gfreundl/IR_Thermometer_LCD_Read/wiring on OEM board.jpg

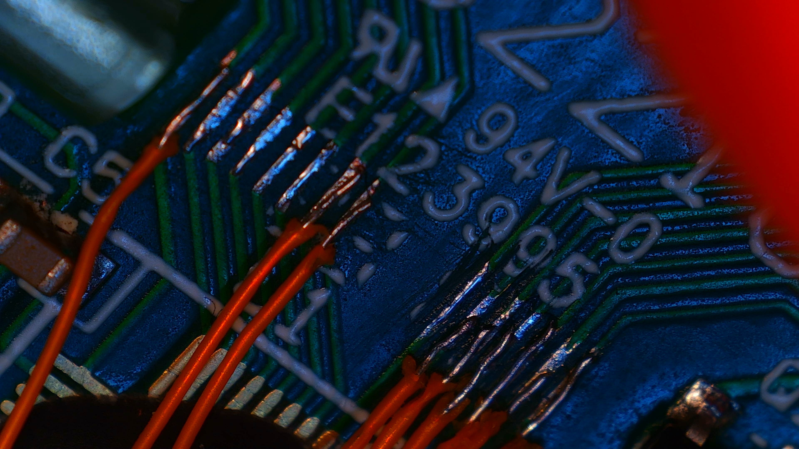
wiring on OEM board.jpg
