gfreundl/IR_Thermometer_LCD_Read/LCD matrix 4xCOM power up 200ms period.png

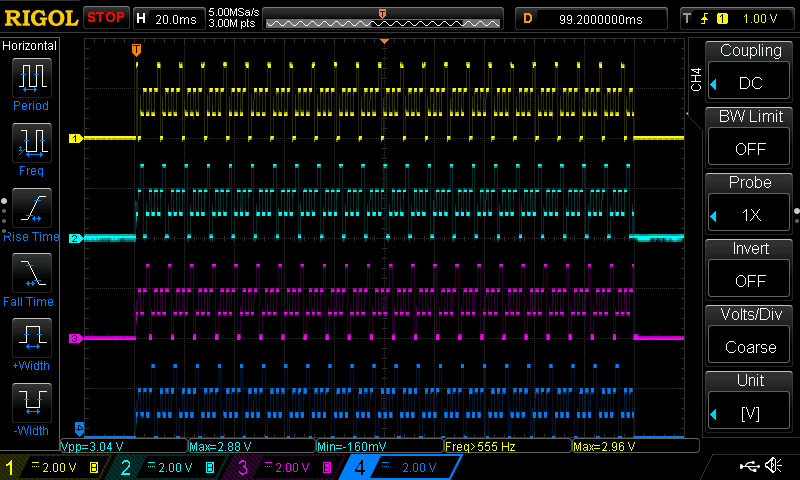
LCD matrix 4xCOM power up 200ms period.png
