gfreundl/IR_Thermometer_LCD_Read/LCD matrix 4xCOM power up initial phase.png

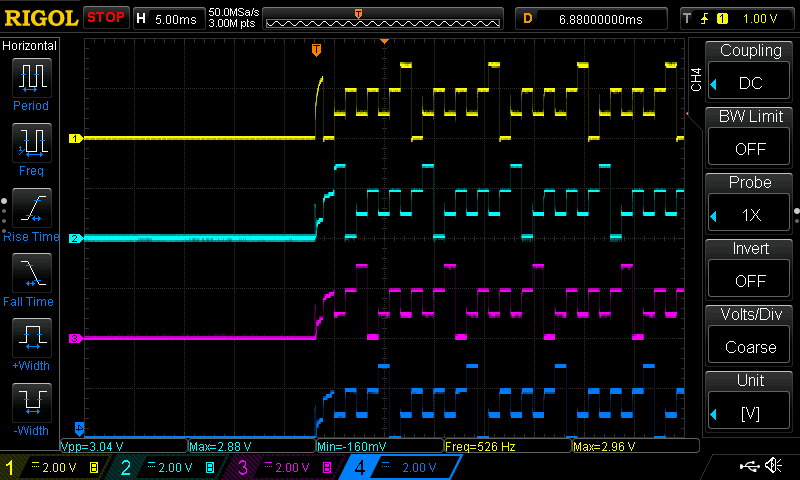
LCD matrix 4xCOM power up initial phase.png
