gfreundl/IR_Thermometer_LCD_Read/LCD matrix 4xCOM startup.png

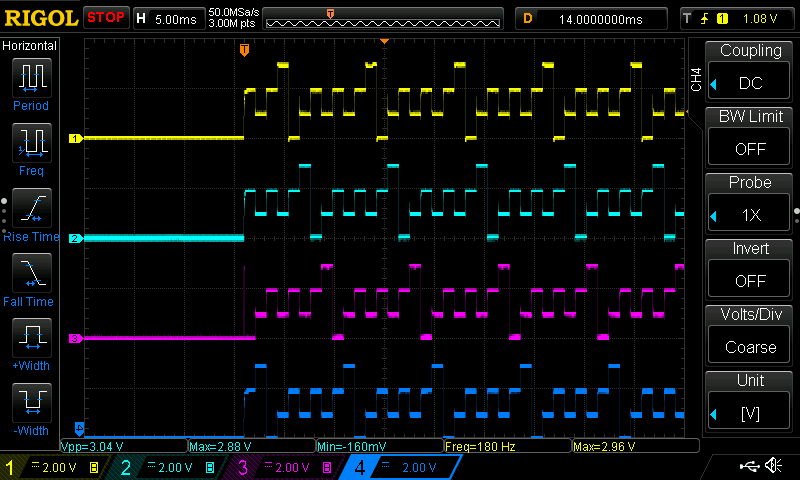
LCD matrix 4xCOM startup.png
