gfreundl/IR_Thermometer_LCD_Read/LCD matrix SEG startup  1960ms all digits.png

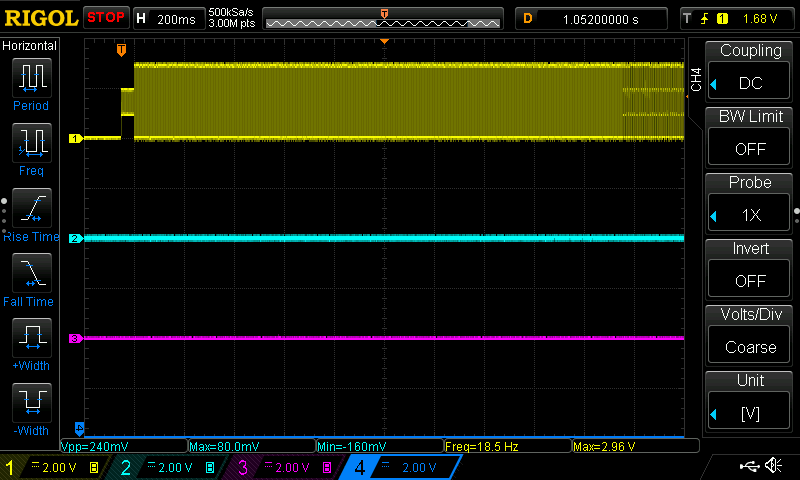
LCD matrix SEG startup 1960ms all digits.png
