gfreundl/IR_Thermometer_LCD_Read/LCD matrix SEG startup detail.png

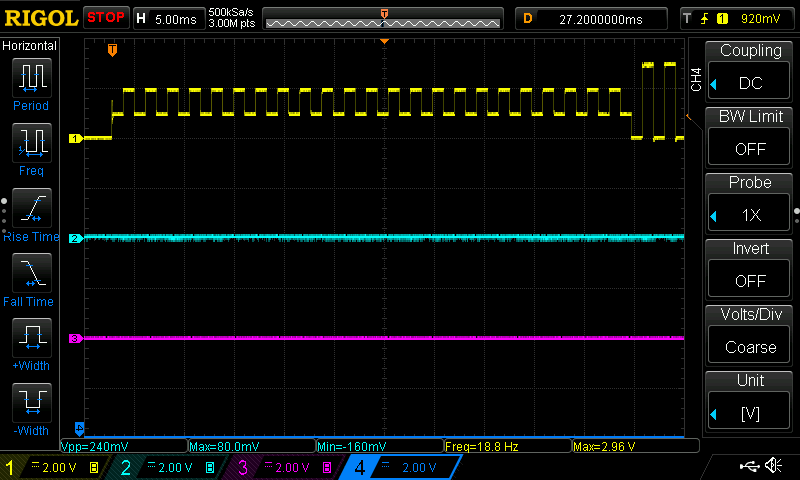
LCD matrix SEG startup detail.png
