gfreundl/IR_Thermometer_LCD_Read/LCD matrix SEG startup total.png

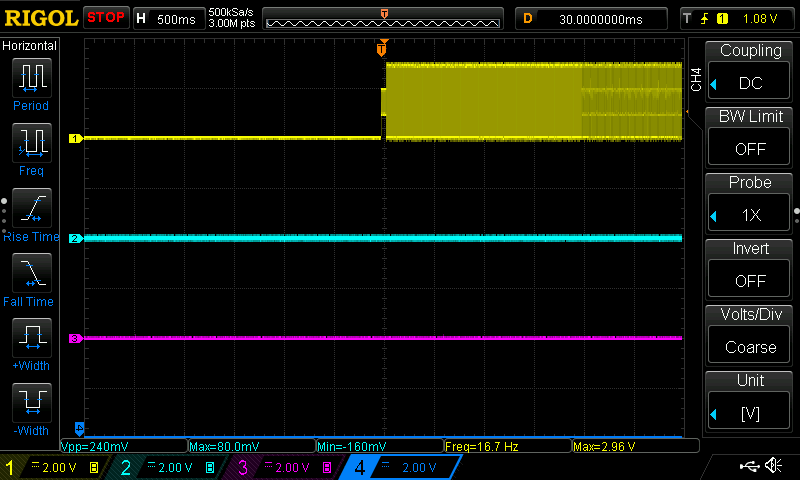
LCD matrix SEG startup total.png
