gfreundl/IR_Thermometer_LCD_Read/normal ops.png

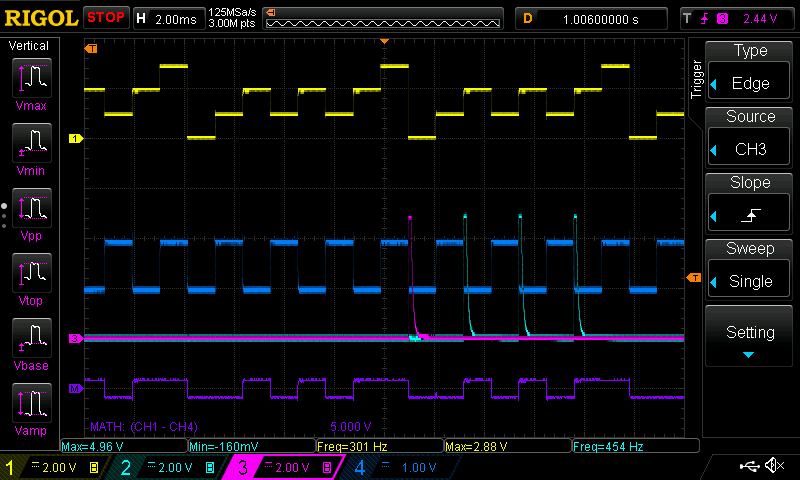
normal ops.png
