gfreundl/IR_Thermometer_LCD_Read/(commit log)

2026-03-11 Revise README with updated results and operation details
    Update frequency and timing details, add operation section, and include sample screenshots.
2026-03-11 Update README with debug output information
    Added information about debug outputs for timer and comparator.
2026-03-11 Update threshold voltage description in README
    Clarified the threshold voltage setup for AIN1 comparator.
2026-03-14 add wiring
2026-03-14 emulate push button
2026-03-17 add Pro Mini 3.3V 8MHz board
